Indigo2233/EFocusor/indi_efocuser/indi_efocuser_focuser.py

#!/usr/bin/env python3
#
# SPDX-License-Identifier: GPL-2.0-or-later
# Copyright (C) 2024–2025 EFucoser Contributors
#
"""
EFucoser INDI Focuser Driver
=============================
Pure Python INDI driver for EFucoser Arduino Nano ULN2003 focuser.
Communicates via INDI XML protocol over stdin/stdout.

Usage:  indiserver -v indi_efocuser_focuser
"""

import sys, os, time, json, threading, logging, tempfile
import xml.etree.ElementTree as ET
import serial, serial.tools.list_ports

# ── Constants ────────────────────────────────────────────────────────────

DEVICE = "EFucoser Focuser"
VERSION = "1.1.1"
BAUD = 9600
TIMEOUT = 2.0
DEF_MAX = 816000
DEF_SPEED = 800
DEF_ACCEL = 1000
POLL_S = 0.5

NUMBER_ELEMENTS = {
    "FOCUS_SPEED": "FOCUS_SPEED_VALUE",
    "ACCELERATION": "ACCELERATION_VALUE",
    "FOCUS_MAX": "FOCUS_MAX_VALUE",
    "ABS_FOCUS_POSITION": "FOCUS_ABSOLUTE_POSITION",
    "REL_FOCUS_POSITION": "FOCUS_RELATIVE_POSITION",
    "FOCUS_TIMER": "FOCUS_TIMER_VALUE",
    "FOCUS_TEMPERATURE": "TEMPERATURE",
}

# ── Helpers ──────────────────────────────────────────────────────────────

def esc(s):
    return str(s).replace("&","&amp;").replace("<","&lt;").replace(">","&gt;").replace('"',"&quot;")

def now_ts():
    return time.strftime("%Y-%m-%dT%H:%M:%S")

def _def_switch(name, label, value="Off"):
    return f'  <defSwitch name="{esc(name)}" label="{esc(label)}">{value}</defSwitch>'

def _def_number(name, label, fmt, mn, mx, step, value):
    return (f'  <defNumber name="{esc(name)}" label="{esc(label)}" '
            f'format="{esc(fmt)}" min="{mn}" max="{mx}" step="{step}">{value}</defNumber>')

def _def_text(name, label, value):
    return f'  <defText name="{esc(name)}" label="{esc(label)}">{esc(value)}</defText>'

# ── Serial ───────────────────────────────────────────────────────────────

class SerialIO:
    def __init__(self, log):
        self._port = None
        self._s = None
        self._lk = threading.Lock()
        self.log = log

    @property
    def ok(self):
        return self._s and self._s.is_open

    def connect(self, port):
        try:
            self._s = serial.Serial(port, BAUD, timeout=TIMEOUT)
            self._port = port
            time.sleep(2.2)
            self._s.reset_input_buffer()
            ident = self.cmd("#")
            self.log.info("Identity: %s", ident)
            if ident and "EFucoser" in ident:
                return True
            self.log.error("Identity mismatch: got %r", ident)
            self.disconnect()
            return False
        except Exception as e:
            self.log.error("Serial connect exception: %s (%s)", e, type(e).__name__)
            if self._s:
                try: self._s.close()
                except: pass
            self._s = None
            return False

    def disconnect(self):
        if self._s and self._s.is_open:
            try: self._s.close()
            except: pass
        self._s = None

    def cmd(self, c):
        with self._lk:
            if not self.ok: return None
            try:
                if not c.endswith("#"): c += "#"
                self._s.reset_input_buffer()
                self._s.write(c.encode())
                self._s.flush()
                r = self._s.read_until(b"#")
                return r.decode(errors="replace").rstrip("#\r\n") if r else None
            except: return None

    def status(self):
        r = self.cmd("G#")
        if not r: return None
        try:
            a = r.split(";")
            return (int(a[0].replace("P","").strip()), len(a)>1 and "true" in a[1])
        except: return None

    def full(self):
        r = self.cmd("I#")
        if r:
            try:
                s = r.find("{"); e = r.rfind("}")
                if s>=0 and e>s: return json.loads(r[s:e+1])
            except: pass
        return {}

    def move(self, p):
        r = self.cmd(f"M {p}#")
        return r and not r.startswith("ERR")
    def stop(self): self.cmd("S#")
    def set_rev(self, v): self.cmd(f"R {1 if v else 0}#")
    def set_hold(self, v): self.cmd(f"C {1 if v else 0}#")
    def set_max(self, v):
        r = self.cmd(f"D {v}#"); return r and not r.startswith("ERR")
    def set_speed(self, v):
        r = self.cmd(f"X {v}#"); return r and not r.startswith("ERR")
    def set_accel(self, v):
        r = self.cmd(f"A {v}#"); return r and not r.startswith("ERR")
    @staticmethod
    def ports():
        return [p.device for p in serial.tools.list_ports.comports()]

# ── Driver ───────────────────────────────────────────────────────────────

class EFocuserINDI:
    def __init__(self):
        self.log = logging.getLogger("EFocuser")
        self.ser = SerialIO(self.log)
        self.runflag = True

        self.conn = False
        self.pos = 0
        self.moving = False
        self.maxst = DEF_MAX
        self.speed = DEF_SPEED
        self.acc = DEF_ACCEL
        self.rev = False
        self.hold = False
        self.temp = 20.0
        self.inward = False
        self.active_motion = None
        self.active_motion_value = 0
        self.port = ""
        self._out_lk = threading.Lock()

        self._pt = threading.Thread(target=self._poll, daemon=True)

    # ── Output ────────────────────────────────────────────────────────

    def _out(self, tag, attrs, body="", end="/>"):
        a = " ".join(f'{k}="{esc(v)}"' for k,v in attrs.items())
        if body:
            self._write(f"<{tag} {a}>\n{body}\n</{tag}>")
        else:
            self._write(f"<{tag} {a}{end}")

    def _write(self, s):
        with self._out_lk:
            sys.stdout.write(s + "\n")
            sys.stdout.flush()

    def _msg(self, m):
        self.log.info(m)
        ts = now_ts()
        self._write(f'<message device="{esc(DEVICE)}" name="" timestamp="{ts}" message="{esc(m)}"/>')

    def _delete(self, name):
        ts = now_ts()
        self._write(f'<delProperty device="{esc(DEVICE)}" name="{esc(name)}" timestamp="{ts}"/>')

    # ── Define Properties ─────────────────────────────────────────────

    def define_all(self, requested=""):
        ts = now_ts()

        def wanted(name):
            return not requested or requested == name

        # DRIVER_INFO — required for indiserver to recognize device interface
        # FOCUSER_INTERFACE = 1 << 3 = 8  (NOT 2, that's CCD!)
        if wanted("DRIVER_INFO"):
            self._out("defTextVector", {
                "device": DEVICE, "name": "DRIVER_INFO", "label": "Driver Info",
                "group": "Connection", "perm": "ro", "state": "Idle",
                "timeout": "60", "timestamp": ts,
            }, body=(
                _def_text("DRIVER_NAME", "Name", DEVICE) + "\n" +
                _def_text("DRIVER_EXEC", "Exec", "indi_efocuser_focuser") + "\n" +
                _def_text("DRIVER_VERSION", "Version", VERSION) + "\n" +
                _def_text("DRIVER_INTERFACE", "Interface", "8")
            ))

        # Port text — prefer /dev/ttyUSB* if present, fall back to user-set port
        ports = SerialIO.ports()
        usb_ports = [p for p in ports if "ttyUSB" in p]
        p = usb_ports[0] if usb_ports else (ports[0] if ports else "/dev/ttyUSB0")
        if not self.port or "ttyS" in self.port:
            self.port = p
        if wanted("DEVICE_PORT"):
            self._out("defTextVector", {
                "device": DEVICE, "name": "DEVICE_PORT", "label": "Serial Port",
                "group": "Connection", "perm": "rw", "state": "Idle",
                "timeout": "60", "timestamp": ts,
            }, body=_def_text("PORT", "Port", self.port))

        # Connection switch
        if wanted("CONNECTION"):
            self._out("defSwitchVector", {
                "device": DEVICE, "name": "CONNECTION", "label": "Connection",
                "group": "Main Control", "perm": "rw", "rule": "OneOfMany",
                "state": "Ok" if self.conn else "Idle", "timeout": "60", "timestamp": ts,
            }, body=(
                _def_switch("CONNECT", "Connect", "On" if self.conn else "Off") + "\n" +
                _def_switch("DISCONNECT", "Disconnect", "Off" if self.conn else "On")
            ))

        # Define focuser properties at startup so indiserver caches them
        self.define_focus(requested=requested)

    def define_focus(self, requested=""):
        ts = now_ts()
        mx = self.maxst

        def wanted(name):
            return not requested or requested == name

        def _defN(name, element, label, group, fmt, mn, mxv, step, value, perm="rw"):
            if not wanted(name):
                return
            self._out("defNumberVector", {
                "device":DEVICE,"name":name,"label":label,"group":group,
                "perm":perm,"state":"Ok","timeout":"60","timestamp":ts,
            }, body=_def_number(element,label,fmt,mn,mxv,step,value))

        def _defS(name, label, group, switches, rule="OneOfMany"):
            if not wanted(name):
                return
            self._out("defSwitchVector", {
                "device":DEVICE,"name":name,"label":label,"group":group,
                "perm":"rw","rule":rule,"state":"Ok","timeout":"60","timestamp":ts,
            }, body="\n".join(_def_switch(n,l,v) for n,l,v in switches))

        _defN("FOCUS_SPEED","FOCUS_SPEED_VALUE","Speed","Main Control","%4.0f",1,2000,10,self.speed)
        _defN("ACCELERATION","ACCELERATION_VALUE","Acceleration","Main Control","%5.0f",10,10000,10,self.acc)
        _defN("FOCUS_MAX","FOCUS_MAX_VALUE","Max. Position","Main Control","%7.0f",100,9999999,1000,mx)
        _defN("ABS_FOCUS_POSITION","FOCUS_ABSOLUTE_POSITION","Absolute Position","Main Control","%7.0f",0,mx,1,self.pos)
        _defN("FOCUS_POSITION","FOCUS_POSITION","Position","Main Control","%7.0f",0,mx,1,self.pos,perm="ro")
        _defN("REL_FOCUS_POSITION","FOCUS_RELATIVE_POSITION","Relative Position","Main Control","%7.0f",0,mx,1,0)
        _defS("FOCUS_MOTION","Direction","Main Control",[
            ("FOCUS_INWARD","Inward","Off"),("FOCUS_OUTWARD","Outward","On")])
        _defN("FOCUS_TIMER","FOCUS_TIMER_VALUE","Timer","Main Control","%5.0f",10,60000,10,100)
        _defS("FOCUS_REVERSE_MOTION","Reverse Motion","Options",[
            ("INDI_ENABLED","Enabled","On" if self.rev else "Off"),
            ("INDI_DISABLED","Disabled","Off" if self.rev else "On")])
        _defS("HOLD_MODE","Hold Mode","Options",[
            ("HOLD_ON","On","On" if self.hold else "Off"),
            ("HOLD_OFF","Off","Off" if self.hold else "On")])
        _defN("FOCUS_TEMPERATURE","TEMPERATURE","Temperature","Main Control","%4.1f",-55,125,0.1,self.temp,perm="ro")
        _defS("FOCUS_ABORT_MOTION","Abort Motion","Main Control",[("ABORT","Abort","Off")], rule="AtMostOne")

    def remove_focus(self):
        for n in ["FOCUS_SPEED","ACCELERATION","FOCUS_MAX",
                  "ABS_FOCUS_POSITION","FOCUS_POSITION","REL_FOCUS_POSITION",
                  "FOCUS_MOTION","FOCUS_TIMER","FOCUS_REVERSE_MOTION",
                  "HOLD_MODE","FOCUS_TEMPERATURE","FOCUS_ABORT_MOTION"]:
            self._delete(n)

    # ── Set / Update ──────────────────────────────────────────────────

    def _setS(self, name, pairs, state="Ok"):
        ts = now_ts()
        body = "\n".join(f'  <oneSwitch name="{esc(n)}">{esc(v)}</oneSwitch>' for n,v in pairs)
        self._out("setSwitchVector", {
            "device":DEVICE,"name":name,"state":state,"timestamp":ts,
        }, body=body)

    def _setN(self, name, value, state="Ok"):
        ts = now_ts()
        element = NUMBER_ELEMENTS.get(name, "VALUE")
        self._out("setNumberVector", {
            "device":DEVICE,"name":name,"state":state,"timestamp":ts,
        }, body=f'  <oneNumber name="{element}">{value}</oneNumber>')

    # ── Connection ────────────────────────────────────────────────────

    def do_connect(self):
        self.log.info("do_connect() called, port=%r, conn=%s", self.port, self.conn)
        if self.ser.connect(self.port):
            self.conn = True
            s = self.ser.full()
            if s:
                self.maxst = s.get("maxSteps", DEF_MAX)
                self.speed = s.get("maxSpeed", DEF_SPEED)
                self.acc = s.get("acceleration", DEF_ACCEL)
                self.rev = s.get("reversed", False)
                self.hold = s.get("hold", False)
                self.temp = s.get("lastTemp", 20.0)
            self.define_focus()
            self._setS("CONNECTION", [("CONNECT","On"),("DISCONNECT","Off")])
            self._msg(f"Connected to {self.port}")
            if not self._pt.is_alive():
                self._pt = threading.Thread(target=self._poll, daemon=True)
                self._pt.start()
        else:
            self._setS("CONNECTION", [("CONNECT","Off"),("DISCONNECT","On")], "Alert")
            self._msg(f"Failed: {self.port}")

    def do_disconnect(self):
        self.conn = False
        self.active_motion = None
        self.ser.disconnect()
        self.remove_focus()
        self._setS("CONNECTION", [("CONNECT","Off"),("DISCONNECT","On")])
        self._msg("Disconnected")

    # ── Polling ───────────────────────────────────────────────────────

    def _publish_motion_status(self, position, moving):
        self.pos = position
        self.moving = moving
        state = "Busy" if moving else "Ok"
        self._setN("ABS_FOCUS_POSITION", position, state)
        self._setN("FOCUS_POSITION", position, state)
        if self.active_motion and self.active_motion != "ABS_FOCUS_POSITION":
            self._setN(self.active_motion, self.active_motion_value, state)
        if not moving:
            self.active_motion = None

    def _poll(self):
        c = 0
        while self.runflag:
            time.sleep(POLL_S)
            if not self.conn: continue
            try:
                status = self.ser.status()
                if status is None:
                    continue
                p, m = status
                self._publish_motion_status(p, m)
                c += 1
                if c >= 4:
                    c = 0
                    s = self.ser.full()
                    if s:
                        t = s.get("lastTemp", self.temp)
                        if abs(t - self.temp) > 0.05:
                            self.temp = t; self._setN("FOCUS_TEMPERATURE", t)
            except Exception as e:
                self.log.error("Poll: %s", e)

    # ── XML Parser ────────────────────────────────────────────────────

    def _on_sw(self, root, name):
        for sw in root.findall("oneSwitch"):
            if sw.get("name") == name and sw.text and sw.text.strip() == "On":
                return True
        return False

    def parse(self, data):
        data = data.strip()
        if not data: return
        try:
            root = ET.fromstring(data)
        except ET.ParseError:
            return

        tag = root.tag
        dev = root.get("device","")
        if dev and dev != DEVICE: return
        nm = root.get("name","")

        if tag == "getProperties":
            # indiserver routes definitions to interested clients but does not
            # cache and replay them for clients that connect later.
            self.define_all(nm)
            return

        if tag == "newSwitchVector":
            if nm == "CONNECTION":
                if self._on_sw(root, "CONNECT"): self.do_connect()
                elif self._on_sw(root, "DISCONNECT"): self.do_disconnect()
            elif nm == "FOCUS_ABORT_MOTION":
                if self._on_sw(root, "ABORT"):
                    if self.conn: self.ser.stop()
                    self._setS("FOCUS_ABORT_MOTION", [("ABORT","Off")])
            elif nm == "FOCUS_REVERSE_MOTION":
                if self._on_sw(root, "INDI_ENABLED"):
                    self.rev = True
                    if self.conn: self.ser.set_rev(True)
                    self._setS("FOCUS_REVERSE_MOTION", [("INDI_ENABLED","On"),("INDI_DISABLED","Off")])
                elif self._on_sw(root, "INDI_DISABLED"):
                    self.rev = False
                    if self.conn: self.ser.set_rev(False)
                    self._setS("FOCUS_REVERSE_MOTION", [("INDI_ENABLED","Off"),("INDI_DISABLED","On")])
            elif nm == "HOLD_MODE":
                if self._on_sw(root, "HOLD_ON"):
                    self.hold = True
                    if self.conn: self.ser.set_hold(True)
                    self._setS("HOLD_MODE", [("HOLD_ON","On"),("HOLD_OFF","Off")])
                elif self._on_sw(root, "HOLD_OFF"):
                    self.hold = False
                    if self.conn: self.ser.set_hold(False)
                    self._setS("HOLD_MODE", [("HOLD_ON","Off"),("HOLD_OFF","On")])
            elif nm == "FOCUS_MOTION":
                self.inward = self._on_sw(root, "FOCUS_INWARD")

        elif tag == "newNumberVector":
            e = root.find("oneNumber")
            if e is None or e.text is None: return
            v = e.text.strip()

            if nm == "FOCUS_SPEED":
                self.speed = int(v)
                if self.conn: self.ser.set_speed(self.speed)
                self._setN("FOCUS_SPEED", self.speed)
            elif nm == "ACCELERATION":
                self.acc = int(v)
                if self.conn: self.ser.set_accel(self.acc)
                self._setN("ACCELERATION", self.acc)
            elif nm == "FOCUS_MAX":
                val = int(v)
                if val <= 0: return
                self.maxst = val
                if self.conn: self.ser.set_max(val)
                self._setN("FOCUS_MAX", self.maxst)
            elif nm == "ABS_FOCUS_POSITION":
                t = max(0, min(int(v), self.maxst))
                if self.conn:
                    if self.ser.move(t):
                        self.active_motion = "ABS_FOCUS_POSITION"
                        self.active_motion_value = t
                        self._msg(f"Goto {t}")
                        self._setN("ABS_FOCUS_POSITION", t, "Busy")
                    else:
                        self._setN("ABS_FOCUS_POSITION", self.pos, "Alert")
                else:
                    self._setN("ABS_FOCUS_POSITION", self.pos, "Idle")
            elif nm == "REL_FOCUS_POSITION":
                d = abs(int(v))
                if self.conn:
                    if self.inward:
                        d = -d
                    nt = max(0, min(self.pos + d, self.maxst))
                    if self.ser.move(nt):
                        self.active_motion = "REL_FOCUS_POSITION"
                        self.active_motion_value = abs(d)
                        self._msg(f"Relative {d}")
                        self._setN("REL_FOCUS_POSITION", abs(d), "Busy")
                    else:
                        self._setN("REL_FOCUS_POSITION", abs(d), "Alert")
                else:
                    self._setN("REL_FOCUS_POSITION", abs(d), "Idle")
            elif nm == "FOCUS_TIMER":
                dur = int(v)
                if self.conn and dur > 0:
                    delta = int(dur * self.speed / 1000.0)
                    if self.inward: delta = -delta
                    nt = max(0, min(self.pos + delta, self.maxst))
                    if self.ser.move(nt):
                        self.active_motion = "FOCUS_TIMER"
                        self.active_motion_value = dur
                        self._msg(f"Timer {dur}ms, ~{abs(delta)} steps")
                        self._setN("FOCUS_TIMER", dur, "Busy")
                    else:
                        self._setN("FOCUS_TIMER", dur, "Alert")
                else:
                    self._setN("FOCUS_TIMER", dur, "Idle")

        elif tag == "newTextVector":
            if nm == "DEVICE_PORT":
                e = root.find("oneText[@name='PORT']")
                if e is None:
                    e = root.find("oneText")
                if e is not None and e.text:
                    self.port = e.text.strip()
                    self.log.info("Port: %s", self.port)

    # ── Main Loop ─────────────────────────────────────────────────────

    def run(self):
        self.log.info("EFucoser INDI Focuser v%s starting", VERSION)
        self.define_all()
        sys.stdout.flush()
        time.sleep(0.1)
        self._msg("Driver ready.")

        buf = ""
        while self.runflag:
            try:
                line = sys.stdin.readline()
                if not line: break
                buf += line
                stripped = buf.strip()
                # Only parse when we have a complete XML element:
                # self-closing: <tag .../> or <tag ... />
                # with body: <tag ...>...</tag>
                if stripped.endswith("/>") or stripped.endswith("</" + self._top_tag(buf) + ">"):
                    self.parse(buf)
                    buf = ""
            except KeyboardInterrupt:
                break
            except Exception as e:
                self.log.error("Input: %s", e)
                buf = ""

        self.runflag = False
        if self.conn: self.ser.disconnect()
        self.log.info("Stopped.")

    @staticmethod
    def _top_tag(xml: str) -> str:
        """Extract the top-level tag name from an XML fragment."""
        import re
        m = re.match(r'^\s*<(\w+)', xml)
        return m.group(1) if m else ""

def main():
    logging.basicConfig(
        level=logging.INFO,
        format="%(asctime)s [%(name)s] %(message)s",
        handlers=[
            logging.StreamHandler(sys.stderr),
            logging.FileHandler(
                os.path.join(tempfile.gettempdir(), "efocuser_indi.log"),
                mode="a",
            ),
        ],
    )
    EFocuserINDI().run()

if __name__ == "__main__":
    main()
