Indigo2233/EFocusor/(commit log)

2026-06-27 feat: EFucoser ESP8266 focuser - firmware, ASCOM driver, test client
    - ESP8266 firmware with AP+STA WiFi, Web UI, HTTP API, WebSocket, TCP protocol
    - Edge-triggered manual buttons (prevents GPIO0 floating runaway)
    - Red light night mode for dark adaptation
    - ASCOM IFocuserV3 driver with Serial/TCP transport, auto-detect
    - Position clamping to [0, maxStep] in firmware and driver
    - FocuserTest Windows Forms client
    [ESP8266FocuserFirmware.ino]
2026-06-27 feat: static STA IP support for focuser firmware
    Add staIp, staGateway, staSubnet settings for fixed IP on STA network.
    Empty fields = DHCP (backward compatible).
    [ESP8266FocuserFirmware.ino]
2026-07-03 feat(firmware): add ULN2003 variant
    Add an ESP8266 firmware variant for 35BYJ46 motors driven by ULN2003 boards. Expose DS18B20 temperature readings while leaving temperature compensation movement to clients such as NINA.
2026-07-11 feat(firmware): add Nano ULN2003 build
    Add an Arduino Nano serial firmware for ULN2003-driven 35BYJ46 focusers. Validate focuser device identities before applying ASCOM connection settings.
2026-07-14 feat: add INDI driver + firmware speed/accel commands
    INDI Driver (indi_efocuser/):
    - Pure Python INDI focuser driver for Arduino Nano ULN2003
    - Implements INDI XML protocol over stdin/stdout (no PyIndi dependency)
    - Supports: speed config, acceleration, max position, absolute/relative
    moves, direction, timer moves, reverse, hold mode, temperature, abort
    - DRIVER_INFO declares FOCUSER_INTERFACE=2
    Firmware update (ArduinoNanoFocuserFirmware_ULN2003):
    - Added 'X <speed>#' command to set max speed at runtime
    - Added 'A <accel>#' command to set acceleration at runtime
    - Fixed JSON status (I#) to use incremental Serial.print()
    instead of large String concatenation (Arduino Nano heap safe)
    K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
    [ArduinoNanoFocuserFirmware_ULN2003.ino, indi_efocuser_focuser.py]
2026-07-14 docs: add INDI driver problem report
2026-07-14 fix(indi): restore focuser property discovery
    indiserver forwards definitions only to matching getProperties subscriptions. Respond to discovery requests and use standard INDI focuser property names.
    [indi_efocuser_focuser.py, test_indi_efocuser.py]
2026-07-14 fix: define all focuser properties at startup for indiserver discovery
    Root cause: indiserver does not forward defXXX for properties
    defined after client connection. Only properties defined at
    driver startup are sent to clients via getProperties.
    Fix: call define_focus() from define_all() so all 14 properties
    (DRIVER_INFO, DEVICE_PORT, CONNECTION, FOCUS_SPEED, ACCELERATION,
    FOCUS_MAX, ABS_FOCUS_POSITION, REL_FOCUS_POSITION, FOCUS_MOTION,
    FOCUS_TIMER, FOCUS_REVERSE_MOTION, HOLD_MODE, FOCUS_TEMPERATURE,
    FOCUS_ABORT_MOTION) are defined at startup.
    [indi_efocuser_focuser.py]
2026-07-14 fix: flush stdout after define_all before entering read loop
    [indi_efocuser_focuser.py]
2026-07-15 feat: add CLI control scripts + document KStars compatibility issue
    CLI control scripts:
    - focus.py: simple interactive focuser controller via INDI
    (p=position, gN=goto, +N/-N=relative move, sN=speed, h=halt)
    - focuser_cli.py: earlier version
    KStars compatibility status (indiserver v2.2.3, KStars 3.7.x):
    WORKING:
    - indiserver launches EFucoser driver correctly
    - All 14 properties registered (verified via TCP/UNIX socket)
    - EFucoser tab appears in EkOS/INDI Control Panel
    - CLI control works perfectly via indiserver
    BROKEN:
    - EkOS EFucoser tab: blank panel, no properties displayed
    - INDI Control Panel: 'Could not find property ABS_FOCUS_POSITION'
    (journalctl errors rep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
    [focuser_cli.py]
2026-07-15 fix(indi): emit valid property definitions
    KStars builds properties from defNumber, defSwitch, and defText widgets. one* widgets left definitions empty and caused ABS_FOCUS_POSITION lookups to fail.
    [focuser_cli.py, indi_efocuser_focuser.py, test_indi_efocuser.py]
2026-07-15 fix: prefer /dev/ttyUSB* over /dev/ttyS* as default serial port
    [indi_efocuser_focuser.py]
2026-07-15 fix: DRIVER_INTERFACE 2->8 (FOCUSER=8, CCD=2 was wrong)
    [indi_efocuser_focuser.py]
2026-07-15 fix: add FOCUS_POSITION property for KStars compatibility
    [indi_efocuser_focuser.py]
2026-07-15 feat(ascom): adopt universal driver identity
    Expose one chooser identity for Nano serial and ESP8266 TCP. Remove the non-standard Home action from the ASCOM surface.
2026-07-27 feat(indi): add native EFucoser driver
    Align all firmware variants on speed and acceleration commands so the native driver exposes consistent capabilities. Add upstream staging, documentation, and CI validation against INDI master.
2026-07-27 refactor(focuser): rename driver to IKunFocuser
    Keep accepting the legacy EFucoser firmware identity so existing controllers remain compatible.
2026-07-27 fix(focuser): preserve EFucoser protocol identity
    Keep IKunFocuser as an INDI-only name so existing firmware remains unchanged.
    [ArduinoNanoFocuserFirmware_ULN2003.ino, ESP8266FocuserFirmware.ino, ESP8266FocuserFirmware_ULN2003.ino]
2026-08-03 fix: hold torque, fixed speed 300, INDI release prep
    ESP8266 firmware:
    - Fix hold mode: bypass AccelStepper HALF4WIRE no-op, direct GPIO control
    - Default speed 800→300, acceleration 1000→300 for reliable torque
    INDI native driver:
    - Remove FOCUSER_HAS_VARIABLE_SPEED, lock speed at 300 step/s
    - Delete all FocusSpeedNP references
    Python INDI driver:
    - Add GPL-2.0 LICENSE, CMakeLists.txt, doc/index.md
    - Fix wrapper script hardcoded paths
    - Clean up PROBLEM.md, focus.py
    [ESP8266FocuserFirmware.ino, focuser_cli.py, indi_efocuser_focuser.py, test_indi_efocuser.py]
2026-08-07 docs: update PR description with hardware test results
    - ESP8266 ULN2003 firmware 1103 tested on Arch Linux x86_64
    - All INDI focuser operations verified via KStars/Ekos
    - Serial connection, DS18B20 temperature sensor confirmed
